renkh/Lidar-Scanner/README.md

[materials]: https://i.imgur.com/d9pONmn.jpg "Materials"
[demo]: https://github.com/renkh/Lidar-Scanner/blob/master/images/animation.gif "Demo"
[assembly]: https://imgur.com/Wku4ZV2.jpg "Assembly"
# Lidar Scanner

Lidar scanner is a device capable of scanning small to medium sized rooms and spaces using Lidar. The Lidar sensor illuminates a small target in a scene and measures the distance by calculating the laser return times and wavelengths. The device then calculates the angle of the target in relation to its position and saves an xyz coordinate to an SD card. By knowing the precise xyz coordinates, it is possible to make digital 3D representations of the scenery by using software capable of reading xyz coordinates. Main motivation of this project is to create an affordable 3D scanning Lidar sensor by using readily available parts and microcontrollers at a fraction of the price of comparable commercial 3D scanners.

## Scanning Instructions

  The device is operated by Arduino Uno R3 based microcontroller. When the device starts up, it waits for user input using rudimentary user interface. The menu has 3 options for scanning speed. M1 for regular scanning speed, M2 for a quicker scanning, and M3 for very fast scanning. Once the mode has been selected, the device begins scanning. It rotates the Lidar sensor to the top, spinning it around 360 degrees. Every time the scanner makes a rotation, predefined by the selected mode, lidar sensor moves down a degree. As the scan progresses, the lidar sensor keeps moving down producing azimuthal projection. At the end of the scan, the device stops spinning and produces a success message on the display at which point the user can remove the SD card to gather data, or restart the scan from the beginning.

## Demo

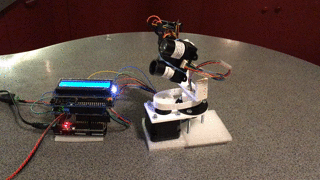
[picture p1: images/animation.gif]
demo


## How it works

  The device consists of a Lidar sensor, a stepper motor, servo motor, Arduino Uno R3 based microcontroller, Adafruit motor shield V2, SD card shield, Adafruit RBG 16x2 LCD display shield, slip ring, and electrolytic diode. Servo motor is connected to the Lidar sensor and rotates the sensor down on the x axis. The position of the servo motor is kept track by the Arduino and corresponds to the x coordinate in the scan file. The servo and Lidar unit is rotated by the stepper motor along the y axis. Slip ring helps keep the wires from tangling up on each other. The position of the stepper motor is kept track by Arduino and corresponds to the y coordinate in the scan file. At each step of the stepper motor, Lidar sensor measures the distance of a point in the scene. The distance measurement corresponds to the z coordinate in the scan file. The device continuously spins, collecting xyz coordinates that are saved to an SD card for later viewing.

## Materials

materials

| Device | Description |
| --- | --- |
| [Arduino Uno R3 based microprocessor](https://www.amazon.com/Elegoo-Board-ATmega328P-ATMEGA16U2-Arduino/dp/B01EWOE0UU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) | Microcontroller handles operation of devices |
| [LIDAR-Lite v3](https://www.amazon.com/Garmin-LYSB01MG3Z3PE-CMPTRACCS-LIDAR-Lite-v3/dp/B01MG3Z3PE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) | Lidar scanner |
| [Stepping Motor](https://www.amazon.com/Stepping-Motor-26Ncm-36-8oz-Printer/dp/B00PNEQ9T4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) | 12V 0.4A 200 steps |
| [Digital RC Servo Motor](https://www.amazon.com/gp/product/B014KONJZY/ref=oh_aui_detailpage_o05_s01?ie=UTF8&psc=1) | 5V ~500 mA |
| [Adafruit Motor/Stepper/Servo Shield](https://www.amazon.com/Adafruit-Motor-Stepper-Shield-Arduino/dp/B00PUTH3B0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) | Driver for stepper and servo motors |
| [Adafruit RGB LCD Shield Kit](https://www.amazon.com/Shield-16x2-Character-Negative-Display-Uses/dp/B00JFJJDGY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) | Adafruit display shield with buttons |
| [SD Card Shield](https://www.amazon.com/HiLetgo-Stackable-Card-Arduino-Shield/dp/B006LRR0IQ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) | Saves output to SD card |
| [Slip Ring](https://www.amazon.com/gp/product/B01L8U2VOI/ref=oh_aui_detailpage_o02_s00?ie=UTF8&psc=1) | Prevents wires from twisting up |

## Assembly

assembly

Soldering is required for some parts. Assembly is straight forward. First assemble the shields if they came in kits.

### Adafruit Motor Shield Assembly
The Adafruit motor shield came partially assembled, I switched out the standard header pins for [stackable headers](https://www.amazon.com/Arduino-Stackable-Header-Kit-R3/dp/B00PCCWEJG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), stackable headers allow you to stack shields. For soldering instructions, visit [Adafruit Motor Shield V2](https://learn.adafruit.com/adafruit-motor-shield-v2-for-arduino/install-headers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) **Install Headers & Terminals** page **Installing with Stacking Headers** subsection.

External power is needed to drive the servo motor. Cut trace along the bottom of the shield where it says **For opt. servo pwr supply cut trace**. You can do it with a knife, make sure the gold contact line is completely severed.
cut trace

Then solder wires to the **opt servo** holes located at the top of the shield. The red wire goes to the hole closest to **Reset** button. Be sure to get this step right, you can risk damage to the servo motor. Connect the wires to a DC power jack, this power jack will be connected to a **5 Vdc** power supply, which will provide enough power to drive the servo. Do not use anything higher than 5 Vdc.

### Adafruit RGB LCD Shield Assembly
The RGB LCD Shield came in a kit and must be assembled before use. The assembly is straight forward, follow [this guide](https://learn.adafruit.com/rgb-lcd-shield/assembly) on Adafruit page for detailed step by step instructions on how to do it.

### Stacking the Shields
Stacking shields on the Arduino is easy and straight forward but can be tricky especially if you are stacking mutiple shields that are of different lengths and sizes. The biggest thing to worry about is making sure that the shields do not compete for the same digital and analog pins. Fortunatley that is not a problem for this project as most of the shields use I2C communication which allows multiple devices to be connected to the same SDA and SCL pins. Here is a schematic of the project.
schematic
Overview of shield stacking
**Arduino Uno -> SD Card Shield -> Adafruit Motor Shield -> Adafruit RGB LCD Shield**
The first shield that goes on top of Arduino Uno is the SD card shield. It uses the SPI bus and needs to be connected to the Arduino first. Next goes the Adafruit Motor Shield, to get better clearance use extra stackable header pins in between the SD card shield and Adafruit Motor shield. This provides extra clearance and allows you to insert SCL and SDA wire jumpers conected from Adafruit Motor shield to Arduino Uno, since SD card shield does not provide them on its circuit board. Then on top of that, stack Adafruit RGB LCD shield, it is an I2C device and only needs SDA and SCL pins to communicate with Arduino Uno.
shields

## Software Installation

Code to run this device is provided in the repository. Download and install [Arduino IDE](https://www.arduino.cc/en/Main/Software). IDE is needed to compile and upload the code to Arduino Uno. The code requires some libraries to run. Libraries that are not included with Arduino IDE need to be download and put into the library folder of arduino. The location of arduino library is in `/Documents/Arduino/libraries`

Libraries needed:

[Adafruit Motor Shield Library](https://learn.adafruit.com/adafruit-motor-shield-v2-for-arduino/install-software)

[Adafruit RGB LCD Shield Library](https://learn.adafruit.com/rgb-lcd-shield/using-the-rgb-lcd-shield)

[Lidar Lite Library](https://github.com/garmin/LIDARLite_v3_Arduino_Library)

## Collecting Data

You can collect data in 2 ways, either with an SD card or through Arduino IDE serial output monitor. SD card saves the output to TEXT.txt file in the following format:
`x_coord,y_coord,z_coord`
where the xyz coordinates are the coordinates of a point in a scene. Alternatively you can output the data directly to a computer through USB connection using Arduino IDE. On startup, click on the right-most button on the toolbar in the Arduino IDE. This will open serial monitor window where the output will appear. Be sure to set the baud rate to 9600 if its not set already. At the end of the run you can save the output to a text file for further viewing.

## Visualizing Data

Visualizing data can be done with many point cloud software programs. Since the output is just an xyz coordinate numbers, you can modify the output to fit any number of point cloud visualization programs. One program in particular that I used is [Scanse Sweep Visualizer](http://scanse.io/downloads).

## Closing Thoughts

My goal is create an affordable 3D scanning Lidar sensor by using readily available parts and microcontrollers at a fraction of the price of comparable commercial 3D scanners. I was able to create a working prototype for $383.79 including all the nuts and bolts as well as extra hardware. However, not all parts are used in the final working version of this device. I feel that with everything I know now, the price can be reduced to less than $300, with the majority of the total cost coming from the Lidar sensor itself. For comparison, the cheapest 3D scanning lidar sensor on the market that's capable of full rotation in horizontal and vertical axis is Scanse Sweep, with their 3D scanner kit the total price comes out to be $748.95.
