renkh/Lidar-Scanner/lidar_stepper_servo_schematic_schem.pdf

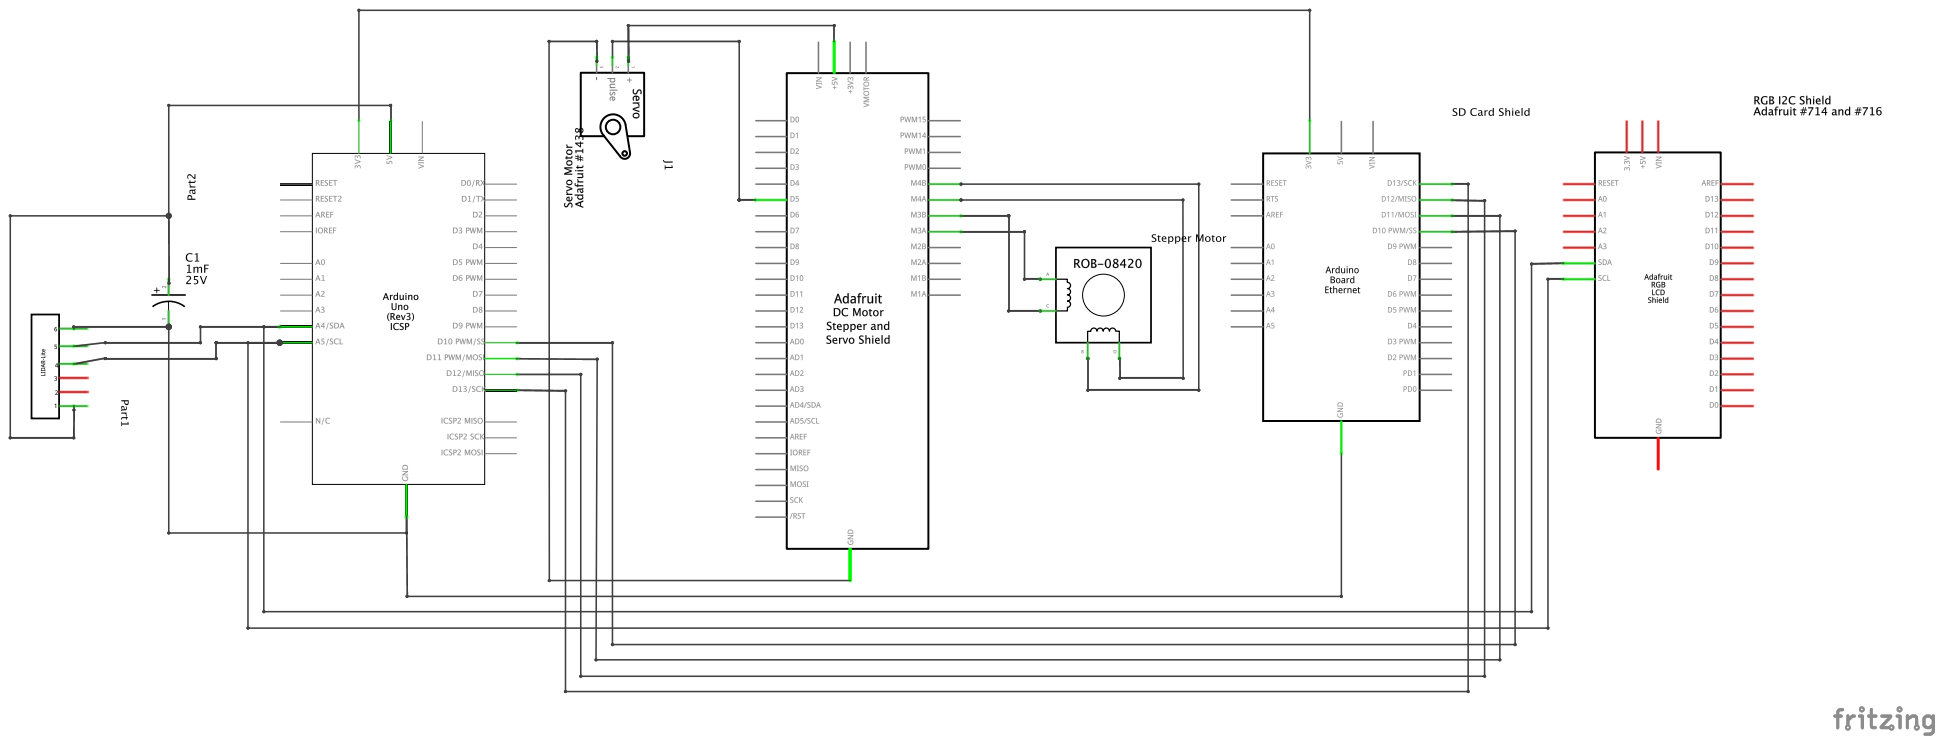
[picture p2: page 1]
