renkh/Lidar-Scanner/(threads)

Thread 1 (2023-01-10):

STL Files of 3D Printed Parts

k7t, 2023-01-10:
The STL files of the 3D printed parts are missing. It would be nice if you add them to the repository.
