renkh/Lidar-Scanner/(commit log)

2017-12-23 added arduino code
2018-01-11 added lidar gif
